CoreElectronics/CE-PiicoDev-Slide-Potentiometer/Documents/CE-PiicoDev-Slide-Potentiometer.pdf

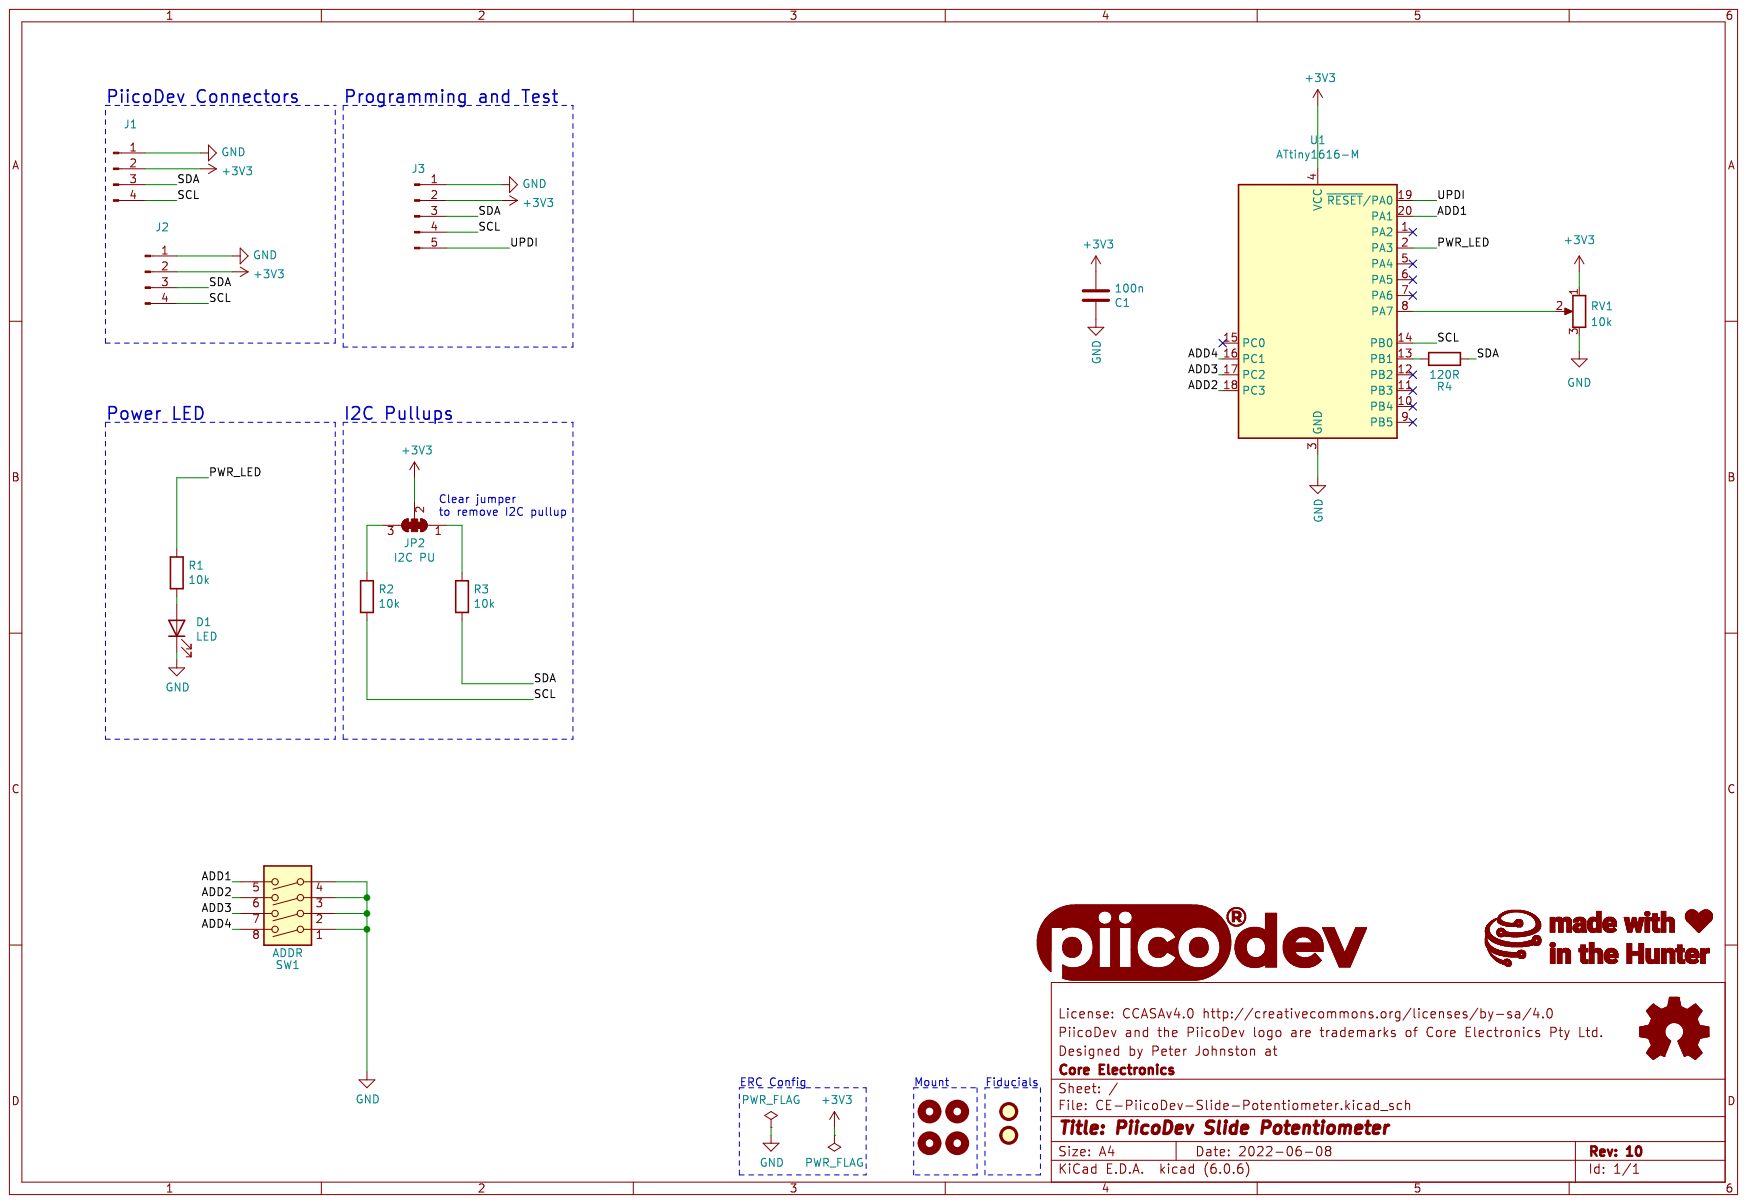
[picture p1: page 1]
