CoreElectronics/CE-PiicoDev-Slide-Potentiometer/(commit log)

2022-04-13 v01 Fix Programming and Test footprint
    [CE-PiicoDev-Slide-Potentiometer.kicad_pcb, CE-PiicoDev-Slide-Potentiometer.kicad_sch]
2022-05-11 Decrease potentiometer pad size
    [CE-PiicoDev-Slide-Potentiometer.kicad_pcb, CE-PiicoDev-Slide-Potentiometer.kicad_sch]
2022-06-17 Change LED pin
    [CE-PiicoDev-Slide-Potentiometer.kicad_pcb, CE-PiicoDev-Slide-Potentiometer.kicad_sch]
2022-06-21 v10 Release
    [CE-PiicoDev-Slide-Potentiometer.kicad_pcb, CE-PiicoDev-Slide-Potentiometer.kicad_sch]
2023-01-10 add potentiometer value
    [CE-PiicoDev-Slide-Potentiometer.kicad_sch]
