CoreElectronics/CE-PiicoDev-Slide-Potentiometer/(notices)

Notices in the files:
PCB/CE-PiicoDev-Slide-Potentiometer.kicad_sch:
License: CCASAv4.0 http://creativecommons.org/licenses/by-sa/4.0
